Celcius1/Old-Projects-become-New/Lyrebird Keyboard/Lyrebird Keyboard Power Supply/Lyrebird Keyboard Power Supply.pdf

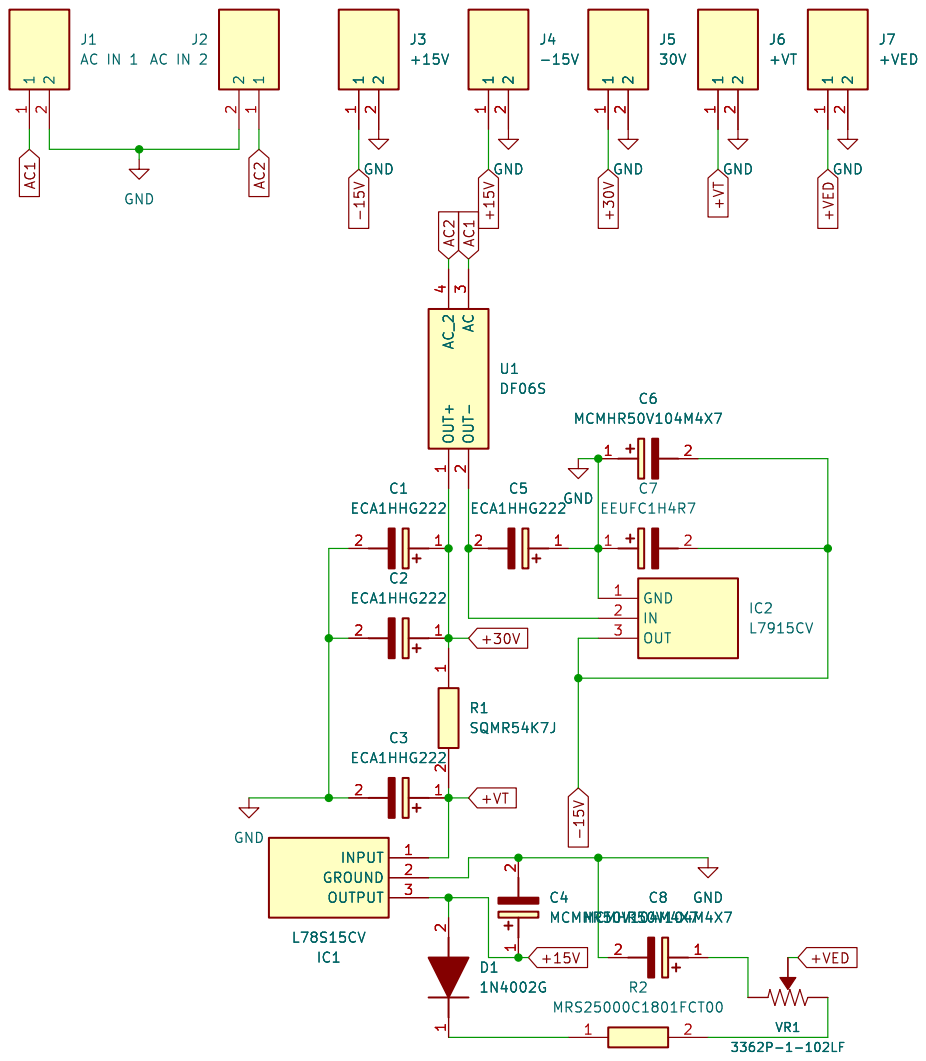
[picture p1: page 1]
