Celcius1/Old-Projects-become-New/Lyrebird Keyboard/Lyrebird Keyboard Tone Generator/Lyrebird Keyboard Tone Generator.pdf

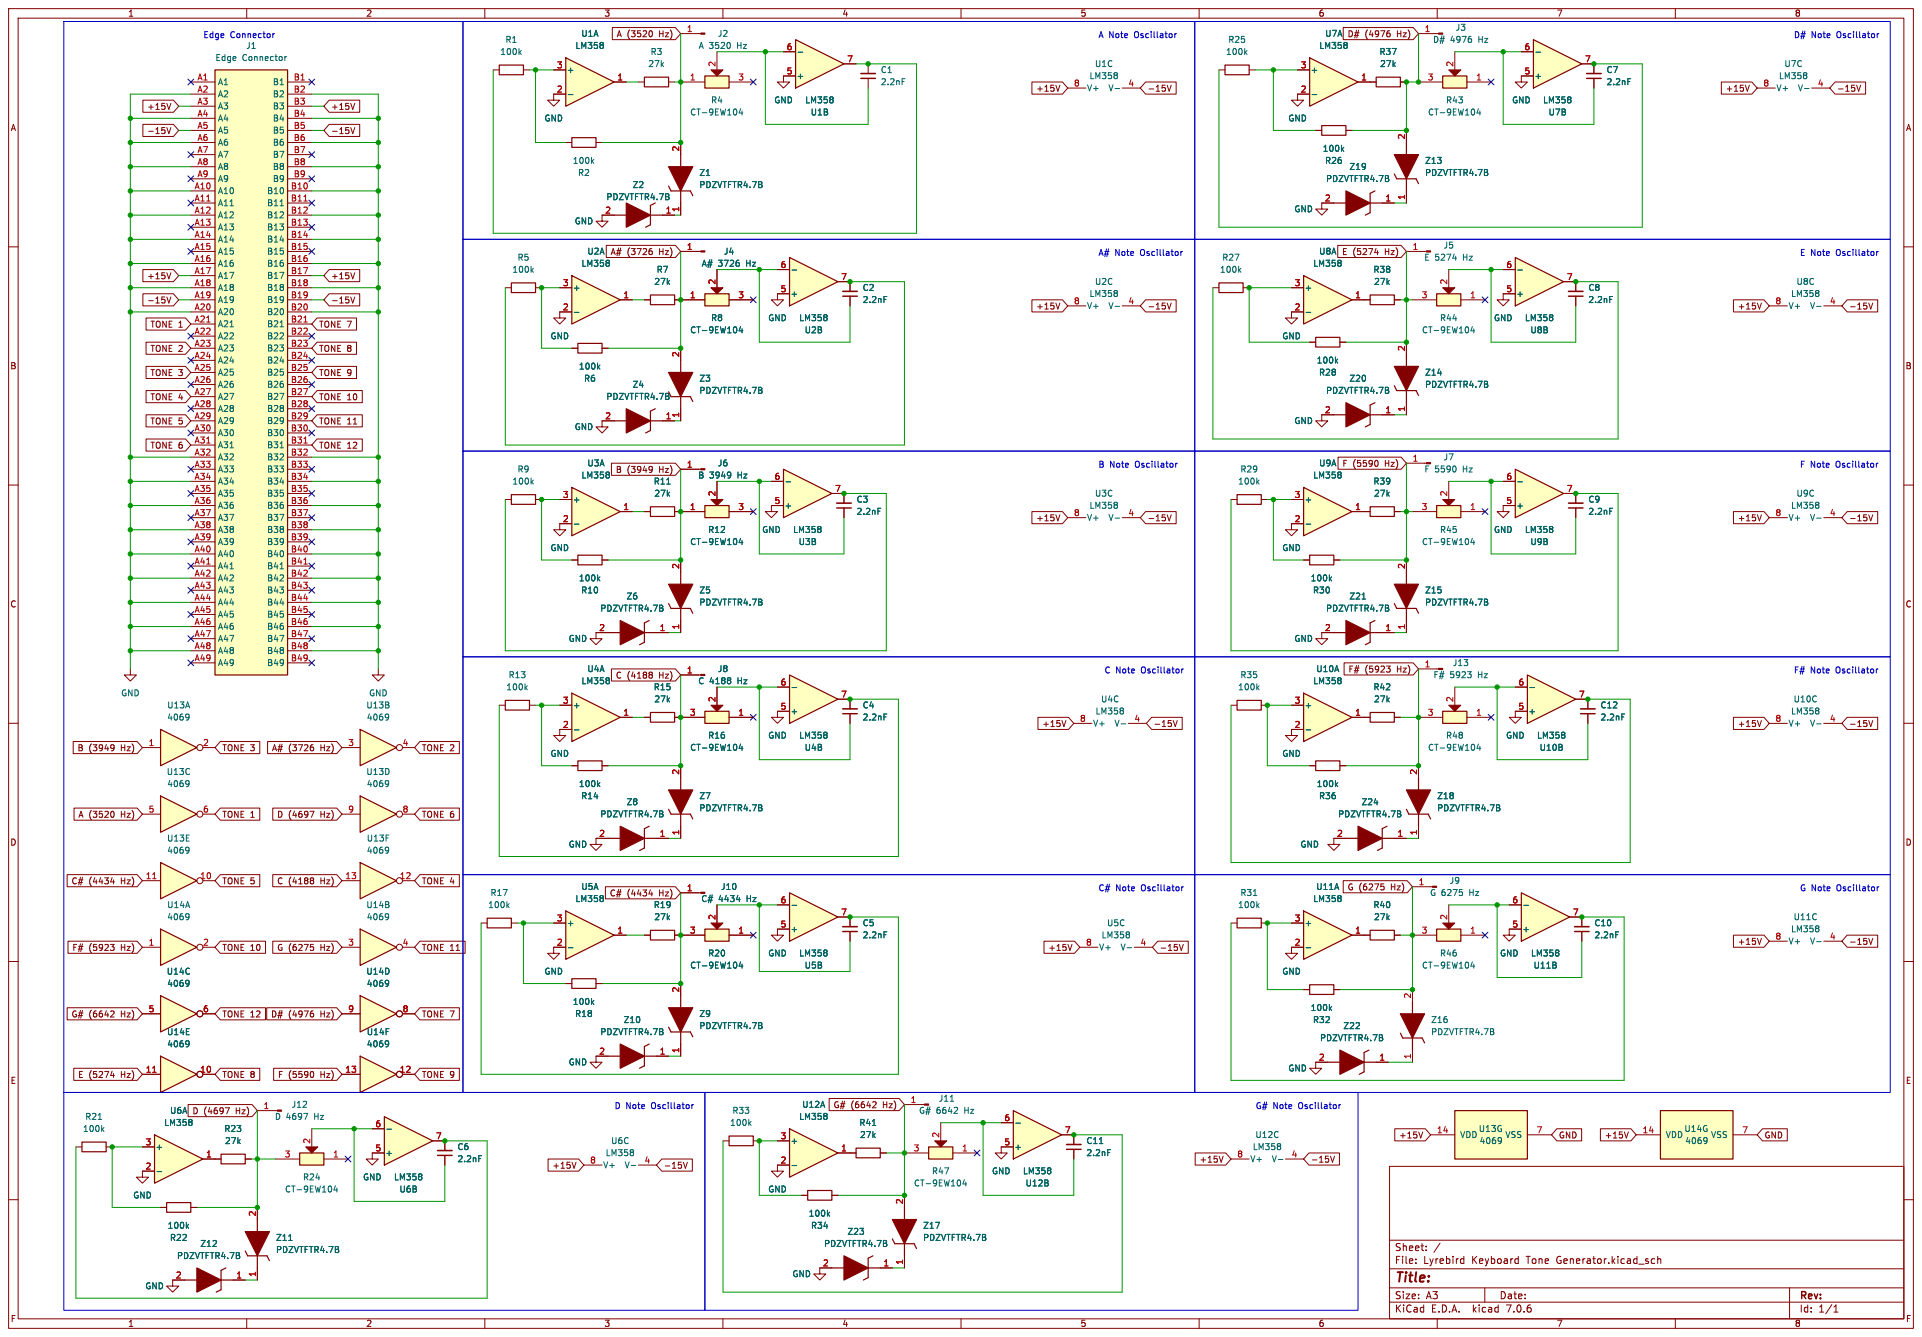
[picture p2: page 1]

E Note Oscillator F Note Oscillator

C Note Oscillator C# Note Oscillator

G Note Oscillator G# Note Oscillator
