Celcius1/Old-Projects-become-New/Lyrebird Keyboard/Lyrebird Keyboard Interconnect Mainboard/Lyrebird Keyboard Interconnect Mainboard.kicad_pcb

## KiCad design Lyrebird Keyboard/Lyrebird Keyboard Interconnect Mainboard/Lyrebird Keyboard Interconnect Mainboard.kicad_pcb (2024-01-26)

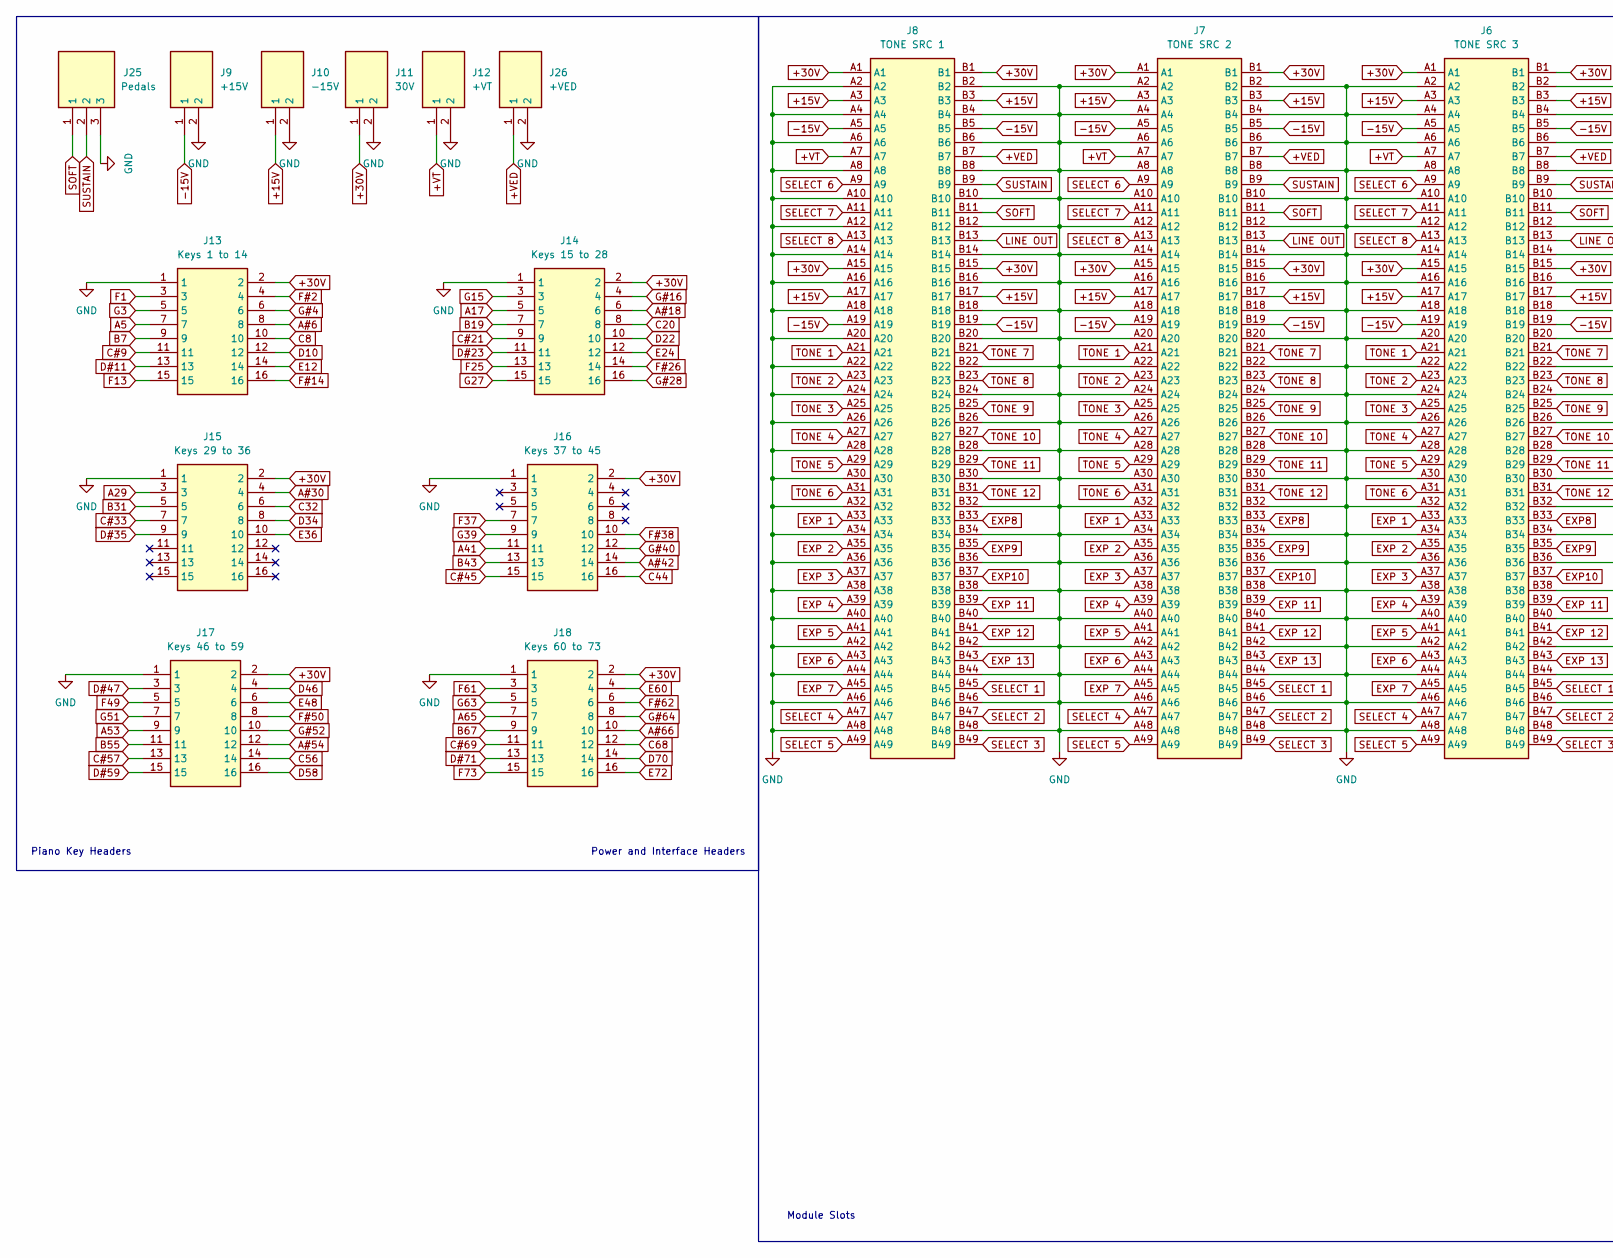
[picture p3: schematic Lyrebird Keyboard Interconnect Mainboard.kicad_sch, Lyrebird Piano Recreation, part in row 1, column 1]

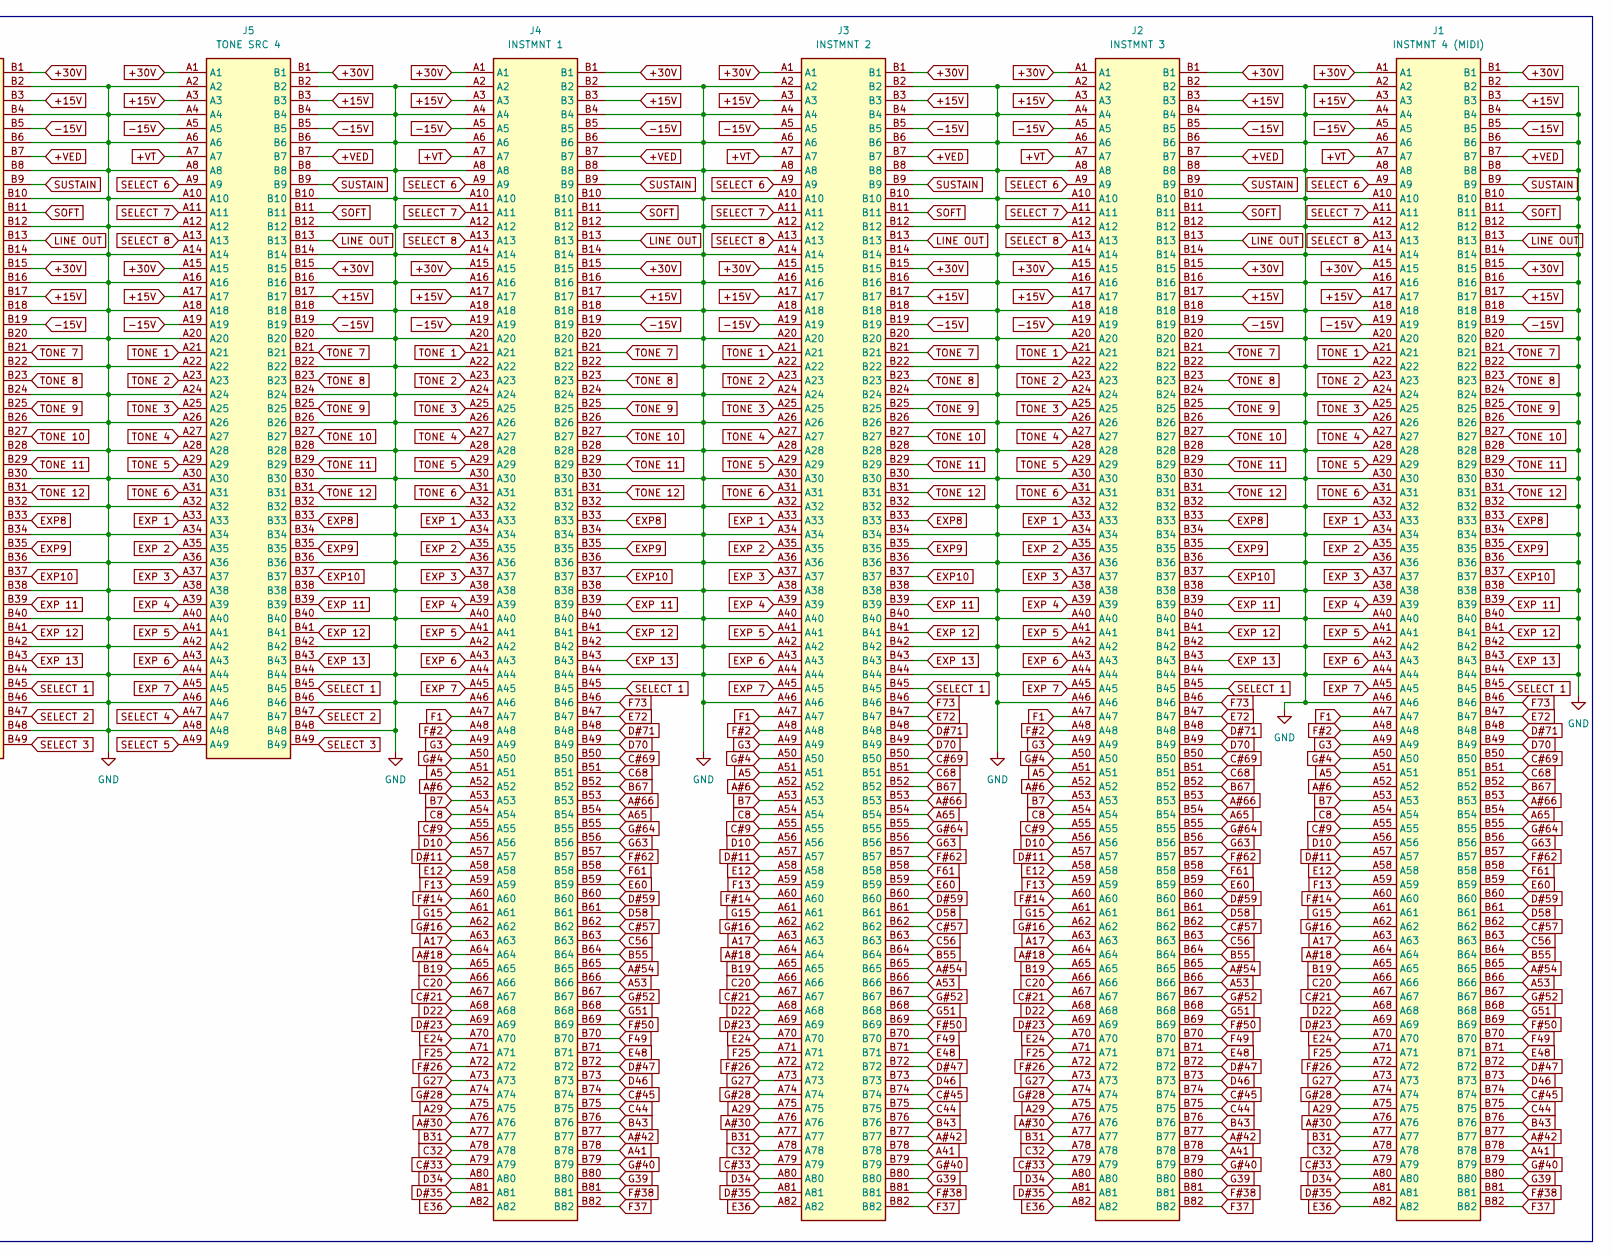
[picture p4: schematic Lyrebird Keyboard Interconnect Mainboard.kicad_sch, Lyrebird Piano Recreation, part in row 1, column 2]

Parts:
J1: INSTMNT 4 (MIDI); 877159306; Manufacturer_Part_Number 87715-9306
J2: INSTMNT 3; 877159306; Manufacturer_Part_Number 87715-9306
J3: INSTMNT 2; 877159306; Manufacturer_Part_Number 87715-9306
J4: INSTMNT 1; 877159306; Manufacturer_Part_Number 87715-9306
J5: TONE SRC 4; 1001878410212TLF; Manufacturer_Part_Number 10018784-10212TLF
J6: TONE SRC 3; 1001878410212TLF; Manufacturer_Part_Number 10018784-10212TLF
J7: TONE SRC 2; 1001878410212TLF; Manufacturer_Part_Number 10018784-10212TLF
J8: TONE SRC 1; 1001878410212TLF; Manufacturer_Part_Number 10018784-10212TLF
J9: +15V; 17761192; Manufacturer_Part_Number 1776119-2
J10: -15V; 17761192; Manufacturer_Part_Number 1776119-2
J11: 30V; 17761192; Manufacturer_Part_Number 1776119-2
J12: +VT; 17761192; Manufacturer_Part_Number 1776119-2
J13: Keys 1 to 14; SHDR16W64P254_2X8_2798X910X910P; Manufacturer_Part_Number MC-254-16-00-ST-DIP
J14: Keys 15 to 28; SHDR16W64P254_2X8_2798X910X910P; Manufacturer_Part_Number MC-254-16-00-ST-DIP
J15: Keys 29 to 36; SHDR16W64P254_2X8_2798X910X910P; Manufacturer_Part_Number MC-254-16-00-ST-DIP
J16: Keys 37 to 45; SHDR16W64P254_2X8_2798X910X910P; Manufacturer_Part_Number MC-254-16-00-ST-DIP
J17: Keys 46 to 59; SHDR16W64P254_2X8_2798X910X910P; Manufacturer_Part_Number MC-254-16-00-ST-DIP
J18: Keys 60 to 73; SHDR16W64P254_2X8_2798X910X910P; Manufacturer_Part_Number MC-254-16-00-ST-DIP
J25: Pedals; CTB05083; Manufacturer_Part_Number CTB0508/3
J26: +VED; 17761192; Manufacturer_Part_Number 1776119-2

Connections:
+15V: J1.A3, J1.A17, J1.B3, J1.B17, J2.A3, J2.A17, J2.B3, J2.B17, J3.A3, J3.A17, J3.B3, J3.B17, J4.A3, J4.A17, J4.B3, J4.B17, J5.A3, J5.A17, J5.B3, J5.B17, J6.A3, J6.A17, J6.B3, J6.B17, J7.A3, J7.A17, J7.B3, J7.B17, J8.A3, J8.A17, J8.B3, J8.B17, J10.1
+30V: J1.A1, J1.A15, J1.B1, J1.B15, J2.A1, J2.A15, J2.B1, J2.B15, J3.A1, J3.A15, J3.B1, J3.B15, J4.A1, J4.A15, J4.B1, J4.B15, J5.A1, J5.A15, J5.B1, J5.B15, J6.A1, J6.A15, J6.B1, J6.B15, J7.A1, J7.A15, J7.B1, J7.B15, J8.A1, J8.A15, J8.B1, J8.B15, J11.1, J13.2, J14.2, J15.2, J16.2, J17.2, J18.2
+VED: J1.B7, J2.B7, J3.B7, J4.B7, J5.B7, J6.B7, J7.B7, J8.B7, J26.1
+VT: J1.A7, J2.A7, J3.A7, J4.A7, J5.A7, J6.A7, J7.A7, J8.A7, J12.1
-15V: J1.A5, J1.A19, J1.B5, J1.B19, J2.A5, J2.A19, J2.B5, J2.B19, J3.A5, J3.A19, J3.B5, J3.B19, J4.A5, J4.A19, J4.B5, J4.B19, J5.A5, J5.A19, J5.B5, J5.B19, J6.A5, J6.A19, J6.B5, J6.B19, J7.A5, J7.A19, J7.B5, J7.B19, J8.A5, J8.A19, J8.B5, J8.B19, J9.1
A5: J1.A51, J2.A51, J3.A51, J4.A51, J13.7
A17: J1.A63, J2.A63, J3.A63, J4.A63, J14.5
A29: J1.A75, J2.A75, J3.A75, J4.A75, J15.3
A41: J1.B78, J2.B78, J3.B78, J4.B78, J16.11
A53: J1.B66, J2.B66, J3.B66, J4.B66, J17.9
A65: J1.B54, J2.B54, J3.B54, J4.B54, J18.7
A#6: J1.A52, J2.A52, J3.A52, J4.A52, J13.8
A#18: J1.A64, J2.A64, J3.A64, J4.A64, J14.6
A#30: J1.A76, J2.A76, J3.A76, J4.A76, J15.4
A#42: J1.B77, J2.B77, J3.B77, J4.B77, J16.14
A#54: J1.B65, J2.B65, J3.B65, J4.B65, J17.12
A#66: J1.B53, J2.B53, J3.B53, J4.B53, J18.10
B7: J1.A53, J2.A53, J3.A53, J4.A53, J13.9
B19: J1.A65, J2.A65, J3.A65, J4.A65, J14.7
B31: J1.A77, J2.A77, J3.A77, J4.A77, J15.5
B43: J1.B76, J2.B76, J3.B76, J4.B76, J16.13
B55: J1.B64, J2.B64, J3.B64, J4.B64, J17.11
B67: J1.B52, J2.B52, J3.B52, J4.B52, J18.9
C8: J1.A54, J2.A54, J3.A54, J4.A54, J13.10
C20: J1.A66, J2.A66, J3.A66, J4.A66, J14.8
C32: J1.A78, J2.A78, J3.A78, J4.A78, J15.6
C44: J1.B75, J2.B75, J3.B75, J4.B75, J16.16
C56: J1.B63, J2.B63, J3.B63, J4.B63, J17.14
C68: J1.B51, J2.B51, J3.B51, J4.B51, J18.12
C#9: J1.A55, J2.A55, J3.A55, J4.A55, J13.11
C#21: J1.A67, J2.A67, J3.A67, J4.A67, J14.9
C#33: J1.A79, J2.A79, J3.A79, J4.A79, J15.7
C#45: J1.B74, J2.B74, J3.B74, J4.B74, J16.15
C#57: J1.B62, J2.B62, J3.B62, J4.B62, J17.13
C#69: J1.B50, J2.B50, J3.B50, J4.B50, J18.11
D10: J1.A56, J2.A56, J3.A56, J4.A56, J13.12
D22: J1.A68, J2.A68, J3.A68, J4.A68, J14.10
D34: J1.A80, J2.A80, J3.A80, J4.A80, J15.8
D46: J1.B73, J2.B73, J3.B73, J4.B73, J17.4
D58: J1.B61, J2.B61, J3.B61, J4.B61, J17.16
D70: J1.B49, J2.B49, J3.B49, J4.B49, J18.14
D#11: J1.A57, J2.A57, J3.A57, J4.A57, J13.13
D#23: J1.A69, J2.A69, J3.A69, J4.A69, J14.11
D#35: J1.A81, J2.A81, J3.A81, J4.A81, J15.9
D#47: J1.B72, J2.B72, J3.B72, J4.B72, J17.3
D#59: J1.B60, J2.B60, J3.B60, J4.B60, J17.15
D#71: J1.B48, J2.B48, J3.B48, J4.B48, J18.13
E12: J1.A58, J2.A58, J3.A58, J4.A58, J13.14
E24: J1.A70, J2.A70, J3.A70, J4.A70, J14.12
E36: J1.A82, J2.A82, J3.A82, J4.A82, J15.10
E48: J1.B71, J2.B71, J3.B71, J4.B71, J17.6
E60: J1.B59, J2.B59, J3.B59, J4.B59, J18.4
E72: J1.B47, J2.B47, J3.B47, J4.B47, J18.16
EXP8: J1.B33, J2.B33, J3.B33, J4.B33, J5.B33, J6.B33, J7.B33, J8.B33
EXP9: J1.B35, J2.B35, J3.B35, J4.B35, J5.B35, J6.B35, J7.B35, J8.B35
EXP10: J1.B37, J2.B37, J3.B37, J4.B37, J5.B37, J6.B37, J7.B37, J8.B37
EXP 1: J1.A33, J2.A33, J3.A33, J4.A33, J5.A33, J6.A33, J7.A33, J8.A33
EXP 2: J1.A35, J2.A35, J3.A35, J4.A35, J5.A35, J6.A35, J7.A35, J8.A35
EXP 3: J1.A37, J2.A37, J3.A37, J4.A37, J5.A37, J6.A37, J7.A37, J8.A37
EXP 4: J1.A39, J2.A39, J3.A39, J4.A39, J5.A39, J6.A39, J7.A39, J8.A39
EXP 5: J1.A41, J2.A41, J3.A41, J4.A41, J5.A41, J6.A41, J7.A41, J8.A41
EXP 6: J1.A43, J2.A43, J3.A43, J4.A43, J5.A43, J6.A43, J7.A43, J8.A43
EXP 7: J1.A45, J2.A45, J3.A45, J4.A45, J5.A45, J6.A45, J7.A45, J8.A45
EXP 11: J1.B39, J2.B39, J3.B39, J4.B39, J5.B39, J6.B39, J7.B39, J8.B39
EXP 12: J1.B41, J2.B41, J3.B41, J4.B41, J5.B41, J6.B41, J7.B41, J8.B41
EXP 13: J1.B43, J2.B43, J3.B43, J4.B43, J5.B43, J6.B43, J7.B43, J8.B43
F1: J1.A47, J2.A47, J3.A47, J4.A47, J13.3
F13: J1.A59, J2.A59, J3.A59, J4.A59, J13.15
F25: J1.A71, J2.A71, J3.A71, J4.A71, J14.13
F37: J1.B82, J2.B82, J3.B82, J4.B82, J16.7
F49: J1.B70, J2.B70, J3.B70, J4.B70, J17.5
F61: J1.B58, J2.B58, J3.B58, J4.B58, J18.3
F73: J1.B46, J2.B46, J3.B46, J4.B46, J18.15
F#2: J1.A48, J2.A48, J3.A48, J4.A48, J13.4
F#14: J1.A60, J2.A60, J3.A60, J4.A60, J13.16
F#26: J1.A72, J2.A72, J3.A72, J4.A72, J14.14
F#38: J1.B81, J2.B81, J3.B81, J4.B81, J16.10
F#50: J1.B69, J2.B69, J3.B69, J4.B69, J17.8
F#62: J1.B57, J2.B57, J3.B57, J4.B57, J18.6
G3: J1.A49, J2.A49, J3.A49, J4.A49, J13.5
G15: J1.A61, J2.A61, J3.A61, J4.A61, J14.3
G27: J1.A73, J2.A73, J3.A73, J4.A73, J14.15
G39: J1.B80, J2.B80, J3.B80, J4.B80, J16.9
G51: J1.B68, J2.B68, J3.B68, J4.B68, J17.7
G63: J1.B56, J2.B56, J3.B56, J4.B56, J18.5
G#4: J1.A50, J2.A50, J3.A50, J4.A50, J13.6
G#16: J1.A62, J2.A62, J3.A62, J4.A62, J14.4
G#28: J1.A74, J2.A74, J3.A74, J4.A74, J14.16
G#40: J1.B79, J2.B79, J3.B79, J4.B79, J16.12
G#52: J1.B67, J2.B67, J3.B67, J4.B67, J17.10
G#64: J1.B55, J2.B55, J3.B55, J4.B55, J18.8
GND: J1.A2, J1.A4, J1.A6, J1.A8, J1.A10, J1.A12, J1.A14, J1.A16, J1.A18, J1.A20, J1.A22, J1.A24, J1.A26, J1.A28, J1.A30, J1.A32, J1.A34, J1.A36, J1.A38, J1.A40, J1.A42, J1.A44, J1.A46, J1.B2, J1.B4, J1.B6, J1.B8, J1.B10, J1.B12, J1.B14, J1.B16, J1.B18, J1.B20, J1.B22, J1.B24, J1.B26, J1.B28, J1.B30, J1.B32, J1.B34, J1.B36, J1.B38, J1.B40, J1.B42, J1.B44, J2.A2, J2.A4, J2.A6, J2.A8, J2.A10, J2.A12, J2.A14, J2.A16, J2.A18, J2.A20, J2.A22, J2.A24, J2.A26, J2.A28, J2.A30, J2.A32, J2.A34, J2.A36, J2.A38, J2.A40, J2.A42, J2.A44, J2.A46, J2.B2, J2.B4, J2.B6, J2.B8, J2.B10, J2.B12, J2.B14, J2.B16, J2.B18, J2.B20, J2.B22, J2.B24, J2.B26, J2.B28, J2.B30, J2.B32, J2.B34, J2.B36, J2.B38, J2.B40, J2.B42, J2.B44, J3.A2, J3.A4, J3.A6, J3.A8, J3.A10, J3.A12, J3.A14, J3.A16, J3.A18, J3.A20, J3.A22, J3.A24, J3.A26, J3.A28, J3.A30, J3.A32, J3.A34, J3.A36, J3.A38, J3.A40, J3.A42, J3.A44, J3.A46, J3.B2, J3.B4, J3.B6, J3.B8, J3.B10, J3.B12, J3.B14, J3.B16, J3.B18, J3.B20, J3.B22, J3.B24, J3.B26, J3.B28, J3.B30, J3.B32, J3.B34, J3.B36, J3.B38, J3.B40, J3.B42, J3.B44, J4.A2, J4.A4, J4.A6, J4.A8, J4.A10, J4.A12, J4.A14, J4.A16, J4.A18, J4.A20, J4.A22, J4.A24, J4.A26, J4.A28, J4.A30, J4.A32, J4.A34, J4.A36, J4.A38, J4.A40, J4.A42, J4.A44, J4.A46, J4.B2, J4.B4, J4.B6, J4.B8, J4.B10, J4.B12, J4.B14, J4.B16, J4.B18, J4.B20, J4.B22, J4.B24, J4.B26, J4.B28, J4.B30, J4.B32, J4.B34, J4.B36, J4.B38, J4.B40, J4.B42, J4.B44, J5.A2, J5.A4, J5.A6, J5.A8, J5.A10, J5.A12, J5.A14, J5.A16, J5.A18, J5.A20, J5.A22, J5.A24, J5.A26, J5.A28, J5.A30, J5.A32, J5.A34, J5.A36, J5.A38, J5.A40, J5.A42, J5.A44, J5.A46, J5.A48, J5.B2, J5.B4, J5.B6, J5.B8, J5.B10, J5.B12, J5.B14, J5.B16, J5.B18, J5.B20, J5.B22, J5.B24, J5.B26, J5.B28, J5.B30, J5.B32, J5.B34, J5.B36, J5.B38, J5.B40, J5.B42, J5.B44, J5.B46, J5.B48, J6.A2, J6.A4, J6.A6, J6.A8, J6.A10, J6.A12, J6.A14, J6.A16, J6.A18, J6.A20, J6.A22, J6.A24, J6.A26, J6.A28, J6.A30, J6.A32, J6.A34, J6.A36, J6.A38, J6.A40, J6.A42, J6.A44, J6.A46, J6.A48, J6.B2, J6.B4, J6.B6, J6.B8, J6.B10, J6.B12, J6.B14, J6.B16, J6.B18, J6.B20, J6.B22, J6.B24, J6.B26, J6.B28, J6.B30, J6.B32, J6.B34, J6.B36, J6.B38, J6.B40, J6.B42, J6.B44, J6.B46, J6.B48, J7.A2, J7.A4, J7.A6, J7.A8, J7.A10, J7.A12, J7.A14, J7.A16, J7.A18, J7.A20, J7.A22, J7.A24, J7.A26, J7.A28, J7.A30, J7.A32, J7.A34, J7.A36, J7.A38, J7.A40, J7.A42, J7.A44, J7.A46, J7.A48, J7.B2, J7.B4, J7.B6, J7.B8, J7.B10, J7.B12, J7.B14, J7.B16, J7.B18, J7.B20, J7.B22, J7.B24, J7.B26, J7.B28, J7.B30, J7.B32, J7.B34, J7.B36, J7.B38, J7.B40, J7.B42, J7.B44, J7.B46, J7.B48, J8.A2, J8.A4, J8.A6, J8.A8, J8.A10, J8.A12, J8.A14, J8.A16, J8.A18, J8.A20, J8.A22, J8.A24, J8.A26, J8.A28, J8.A30, J8.A32, J8.A34, J8.A36, J8.A38, J8.A40, J8.A42, J8.A44, J8.A46, J8.A48, J8.B2, J8.B4, J8.B6, J8.B8, J8.B10, J8.B12, J8.B14, J8.B16, J8.B18, J8.B20, J8.B22, J8.B24, J8.B26, J8.B28, J8.B30, J8.B32, J8.B34, J8.B36, J8.B38, J8.B40, J8.B42, J8.B44, J8.B46, J8.B48, J9.2, J10.2, J11.2, J12.2, J13.1, J14.1, J15.1, J16.1, J17.1, J18.1, J25.3, J26.2
LINE OUT: J1.B13, J2.B13, J3.B13, J4.B13, J5.B13, J6.B13, J7.B13, J8.B13
SELECT 1: J1.B45, J2.B45, J3.B45, J4.B45, J5.B45, J6.B45, J7.B45, J8.B45
SELECT 2: J5.B47, J6.B47, J7.B47, J8.B47
SELECT 3: J5.B49, J6.B49, J7.B49, J8.B49
SELECT 4: J5.A47, J6.A47, J7.A47, J8.A47
SELECT 5: J5.A49, J6.A49, J7.A49, J8.A49
SELECT 6: J1.A9, J2.A9, J3.A9, J4.A9, J5.A9, J6.A9, J7.A9, J8.A9
SELECT 7: J1.A11, J2.A11, J3.A11, J4.A11, J5.A11, J6.A11, J7.A11, J8.A11
SELECT 8: J1.A13, J2.A13, J3.A13, J4.A13, J5.A13, J6.A13, J7.A13, J8.A13
SOFT: J1.B11, J2.B11, J3.B11, J4.B11, J5.B11, J6.B11, J7.B11, J8.B11, J25.1
SUSTAIN: J1.B9, J2.B9, J3.B9, J4.B9, J5.B9, J6.B9, J7.B9, J8.B9, J25.2
TONE 1: J1.A21, J2.A21, J3.A21, J4.A21, J5.A21, J6.A21, J7.A21, J8.A21
TONE 2: J1.A23, J2.A23, J3.A23, J4.A23, J5.A23, J6.A23, J7.A23, J8.A23
TONE 3: J1.A25, J2.A25, J3.A25, J4.A25, J5.A25, J6.A25, J7.A25, J8.A25
TONE 4: J1.A27, J2.A27, J3.A27, J4.A27, J5.A27, J6.A27, J7.A27, J8.A27
TONE 5: J1.A29, J2.A29, J3.A29, J4.A29, J5.A29, J6.A29, J7.A29, J8.A29
TONE 6: J1.A31, J2.A31, J3.A31, J4.A31, J5.A31, J6.A31, J7.A31, J8.A31
TONE 7: J1.B21, J2.B21, J3.B21, J4.B21, J5.B21, J6.B21, J7.B21, J8.B21
TONE 8: J1.B23, J2.B23, J3.B23, J4.B23, J5.B23, J6.B23, J7.B23, J8.B23
TONE 9: J1.B25, J2.B25, J3.B25, J4.B25, J5.B25, J6.B25, J7.B25, J8.B25
TONE 10: J1.B27, J2.B27, J3.B27, J4.B27, J5.B27, J6.B27, J7.B27, J8.B27
TONE 11: J1.B29, J2.B29, J3.B29, J4.B29, J5.B29, J6.B29, J7.B29, J8.B29
TONE 12: J1.B31, J2.B31, J3.B31, J4.B31, J5.B31, J6.B31, J7.B31, J8.B31

Notes on the sheet:
Piano Key Headers
Power and Interface Headers
Module Slots

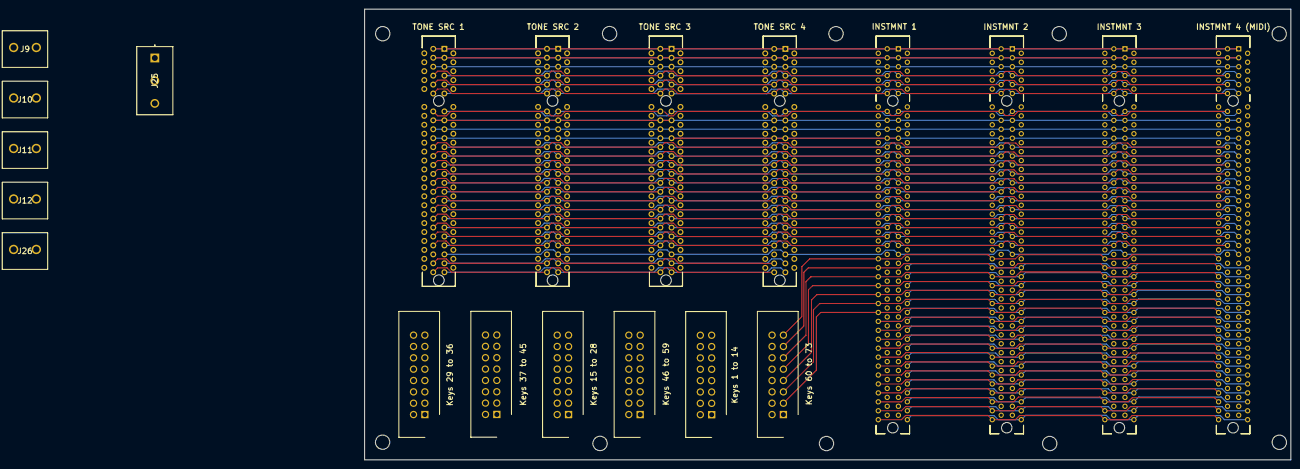
[picture p5: board Lyrebird Keyboard Interconnect Mainboard.kicad_pcb from above]

Board: 4 copper layers, 207.3 x 100.9 mm, 20 parts (0 on the bottom side), 115 nets.
