Celcius1/Old-Projects-become-New/Lyrebird Keyboard/Lyrebird Keyboard Class D Amp Card/Lyrebird Keyboard Class D Amp Card.kicad_pcb

## KiCad design Lyrebird Keyboard/Lyrebird Keyboard Class D Amp Card/Lyrebird Keyboard Class D Amp Card.kicad_pcb (2023-12-20)

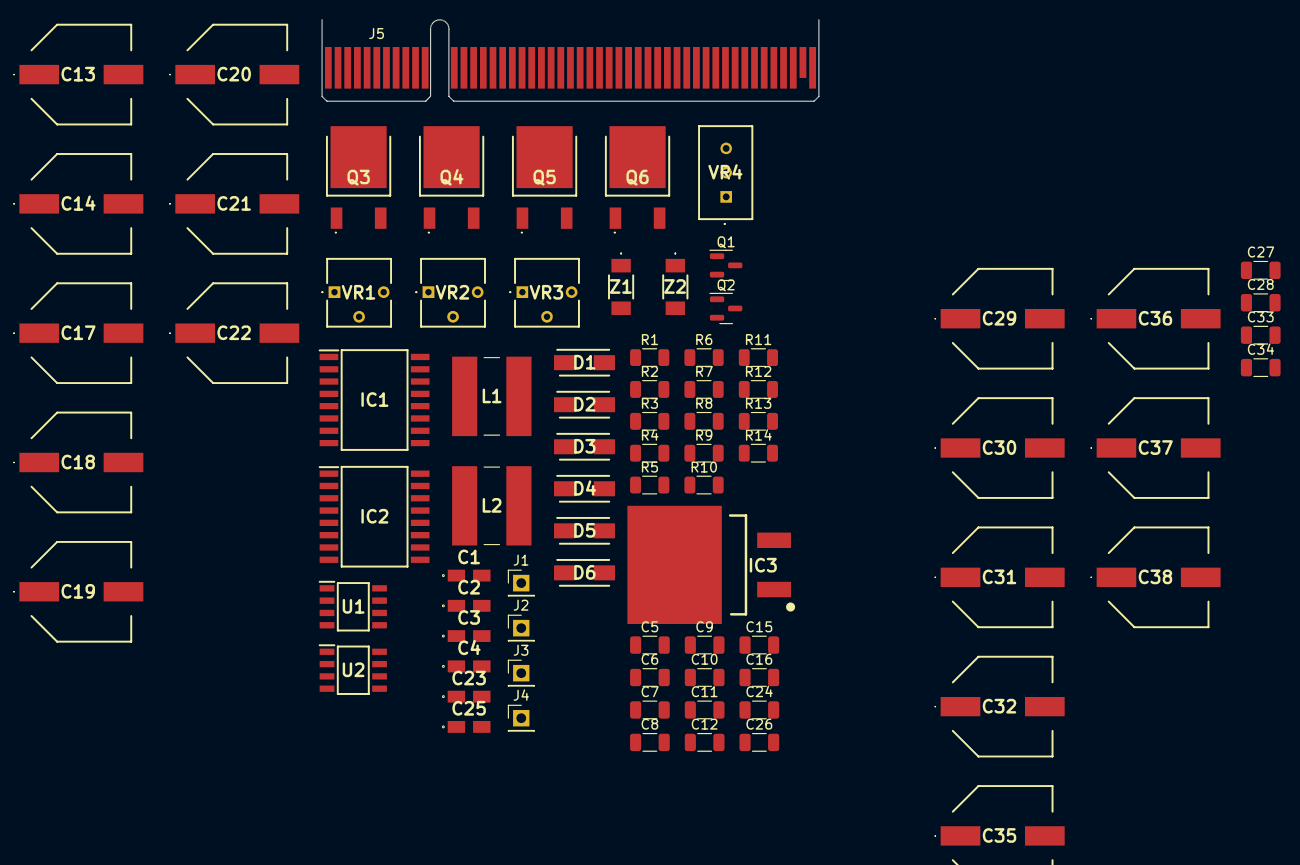
[picture p6: board Lyrebird Keyboard Class D Amp Card.kicad_pcb from above]

Board: 2 copper layers, 82 parts (0 on the bottom side), 36 nets, no tracks yet.

Parts:
C1, C2, C3, C4, C23, C25: T491A225K016AT; T491A
C5, C6, C11, C12, C28, C34: 220nF; C_1206_3216Metric
C7, C8: 22uF; C_1206_3216Metric
C9, C10, C27, C33: 100nF; C_1206_3216Metric
C13, C14, C17, C18, C19, C20, C21, C22, C29, C30, C31, C32, C35, C36, C37, C38: EEEFK1H221P; EEE0JA152UAP
C15: 390nF; C_1206_3216Metric
C16: 5.6uF; C_1206_3216Metric
C24: 68nF; C_1206_3216Metric
C26: 1nF; C_1206_3216Metric
D1, D2, D3, D4, D5, D6: US1M-E3_5AT; DIOM5127X229N
IC1, IC2: IR2113SPBF; SOIC127P1032X265-16N
IC3: L7805ACD2T-TR; D2PAK-STB35NF10T4
J1: Bias Test Point 1; PinHeader_1x01_P2.54mm_Vertical
J2: Bias Test Point 2; PinHeader_1x01_P2.54mm_Vertical
J3: Square Test; PinHeader_1x01_P2.54mm_Vertical
J4: Triangle Test; PinHeader_1x01_P2.54mm_Vertical
J5: Edge Connector; BUS_PCIexpress_x8
L1, L2: SRN8040-220M; SRN8040220M
Q1, Q2: BC848; SOT-23
Q3, Q4, Q5, Q6: IRFR2905ZTRPBF
R1, R2, R3, R4, R5, R6, R11: 10k; R_1206_3216Metric
R7, R8, R9, R10: 10R; R_1206_3216Metric
R12, R13: 100k; R_1206_3216Metric
R14: 5k1; R_1206_3216Metric
U1: SOIC127P600X175-8N
U2: LM358; SOIC127P600X175-8N
VR1, VR2, VR3: T73YP103KT20
VR4: CT-9EW104; CT9EW104
Z1, Z2: PDZVTFTR4.7B; PDZVTFTR47B

Connections:
+5V: C1.1 (+), C2.1 (+), C3.1 (+), C4.1 (+), C23.1 (+), C25.1 (+), IC1.11 (VDD), IC2.11 (VDD), IC3.3 (OUTPUT), R3.1, R4.1, R5.2, R6.2, U1.8 (Vdd), U2.8 (V+), VR2.3 (CW), VR3.3 (CW)
+15V: C9.2, C10.2, C11.2, C12.2, C13.1 (+), C14.1 (+), C17.1 (+), C18.1 (+), C19.1 (+), C20.1 (+), C21.1 (+), C22.1 (+), D1.2 (A), D2.2 (A), IC1.3 (VCC), IC2.3 (VCC), IC3.1 (INPUT), J5.A3, J5.A17, J5.B3, J5.B17, Q3.2 (D), Q5.2 (D)
-15V: C27.1, C28.1, C29.2 (-), C30.2 (-), C31.2 (-), C32.2 (-), C33.1, C34.1, C35.2 (-), C36.2 (-), C37.2 (-), C38.2 (-), J5.A5, J5.A19, J5.B5, J5.B19, Q4.3 (S), Q6.3 (S)
AMP OUT: C15.2, L1.2
GND: C1.2 (-), C2.2 (-), C3.2 (-), C4.2 (-), C9.1, C10.1, C11.1, C12.1, C13.2 (-), C14.2 (-), C15.1, C16.1, C17.2 (-), C18.2 (-), C19.2 (-), C20.2 (-), C21.2 (-), C22.2 (-), C23.2 (-), C24.1, C25.2 (-), C27.2, C28.2, C29.1 (+), C30.1 (+), C31.1 (+), C32.1 (+), C33.2, C34.2, C35.1 (+), C36.1 (+), C37.1 (+), C38.1 (+), IC1.13 (SD), IC2.13 (SD), IC3.4 (GND), J5.A2, J5.A4, J5.A6, J5.A8, J5.A10, J5.A12, J5.A14, J5.A16, J5.A18, J5.A20, J5.A32, J5.A34, J5.A36, J5.A38, J5.A40, J5.A42, J5.A44, J5.A46, J5.A48, J5.B2, J5.B4, J5.B6, J5.B8, J5.B10, J5.B12, J5.B14, J5.B16, J5.B18, J5.B20, J5.B32, J5.B34, J5.B36, J5.B38, J5.B40, J5.B42, J5.B44, J5.B46, J5.B48, Q1.2 (E), Q2.2 (E), U1.4 (Vss), U2.2 (-), U2.4 (V-), U2.5 (+), VR2.1 (CCW), VR3.1 (CCW), Z1.2 (A)
HIN1: IC1.12 (HIN), R1.1, R6.1, U1.7
HIN2: IC2.12 (HIN), R2.1, R5.1, U1.1
HO1: D5.1 (K), IC1.8 (HO), R9.2
HO2: D3.1 (K), IC2.8 (HO), R7.2
LINE INV: IC2.14 (LIN), Q2.3 (C), R4.2
LINE OUT: J5.B13, VR1.3 (CW)
LO1: D6.1 (K), IC1.1 (LO), R10.2
LO2: D4.1 (K), IC2.1 (LO), R8.2
unnamed: D3.2 (A), Q3.1 (G), R7.1
unnamed: D4.2 (A), Q4.1 (G), R8.1
unnamed: D5.2 (A), Q5.1 (G), R9.1
unnamed: D6.2 (A), Q6.1 (G), R10.1
unnamed: J1.1, U1.2 (-), VR1.1 (CCW), VR2.2 (WIPER)
unnamed: J3.1, R13.1, R14.2, VR4.1 (CCW), Z2.2 (A)
unnamed: Q1.1 (B), R1.2
unnamed: Q2.1 (B), R2.2
unnamed: R14.1, U2.1
unnamed: C24.2, R11.1, U1.6 (-)
unnamed: R12.2, R13.2, U2.3 (+)
unnamed: C26.1, U2.6 (-), VR4.2 (WIPER)
unnamed: Z1.1 (K), Z2.1 (K)
SUB IN: J2.1, R11.2, VR1.2 (WIPER), VR3.2 (WIPER)
SUB INV: IC1.14 (LIN), Q1.3 (C), R3.2
SUBWOOFER: C16.2, L2.2
TRI WAVE OUT: C26.2, J4.1, R12.1, U1.3 (+), U1.5 (+), U2.7
VB1: C6.1, C8.2, D2.1 (K), IC1.7 (VB)
VB2: C5.1, C7.2, D1.1 (K), IC2.7 (VB)
VS1: C6.2, C8.1, IC1.6 (VS), L2.1, Q5.3 (S), Q6.2 (D)
VS2: C5.2, C7.1, IC2.6 (VS), L1.1, Q3.3 (S), Q4.2 (D)
VSS1: IC1.2 (COM), IC1.15 (VSS)
VSS2: IC2.2 (COM), IC2.15 (VSS)
