Celcius1/Old-Projects-become-New/Lyrebird Keyboard/Lyrebird Keyboard Power Supply/Lyrebird Keyboard Power Supply.kicad_pcb

## KiCad design Lyrebird Keyboard/Lyrebird Keyboard Power Supply/Lyrebird Keyboard Power Supply.kicad_pcb (2023-12-20)

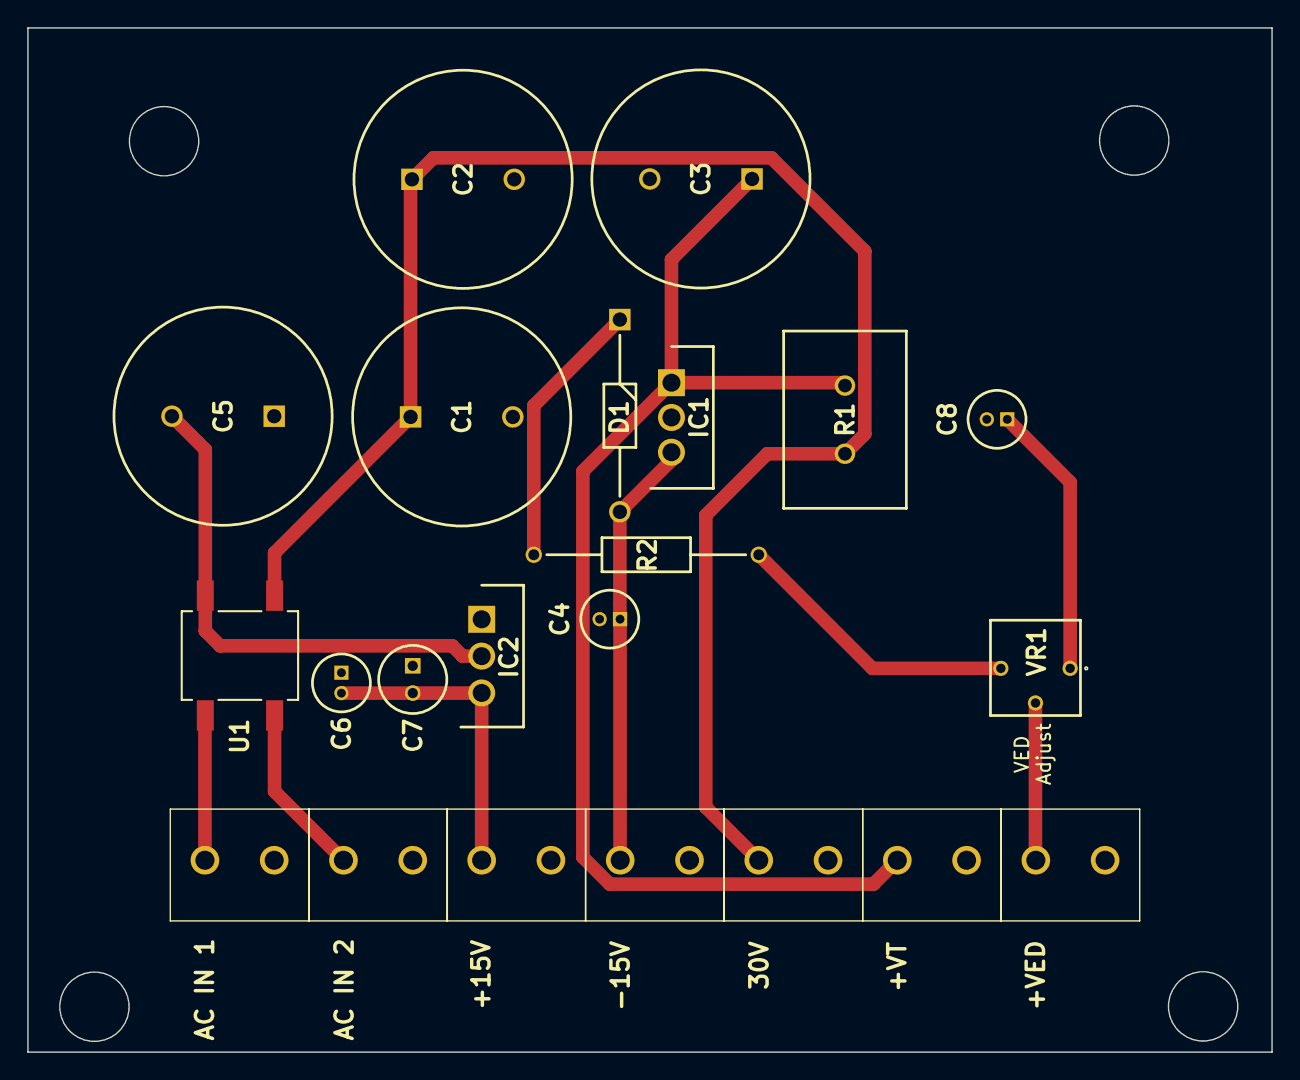
[picture p7: board Lyrebird Keyboard Power Supply.kicad_pcb from above]

Board: 2 copper layers, 91.2 x 75.1 mm, 22 parts (0 on the bottom side), 12 nets.

Parts:
C1, C2, C3, C5: ECA1HHG222; CAPPRD750W85D1600H3350
C4, C6, C8: MCMHR50V104M4X7; CAPPRD150W47D425H800
C7: EEUFC1H4R7; CAPPRD200W55D500H1250
D1: 1N4002G; DIOAD1405W86L465D235
IC1: L78S15CV; TO255P460X1020X2008-3P
IC2: L7915CV; TO270P460X1020X2008-3P
J1: AC IN 1; 17761192
J2: AC IN 2; 17761192
J3: +15V; 17761192
J4: -15V; 17761192
J5: 30V; 17761192
J6: +VT; 17761192
J7: +VED; 17761192
R1: SQMR54K7J
R2: MRS25000C1801FCT00; RESAD1650W60L650D250
U1: DF06S; SOT508P985X260-4N
VR1: 3362P-1-102LF; 3362P_1

Connections:
+15V: C4.1 (+), D1.2 (A), IC1.3 (OUTPUT), J4.1
+30V: C1.1 (+), C2.1 (+), J5.1, R1.1, U1.1 (OUT+)
+VED: J7.1, VR1.2 (WIPER)
+VT: C3.1 (+), IC1.1 (INPUT), J6.1, R1.2
-15V: C6.2 (-), C7.2 (-), IC2.3 (OUT), J3.1
AC1: J1.1, U1.3 (AC)
AC2: J2.1, U1.4 (AC_2)
GND: C1.2 (-), C2.2 (-), C3.2 (-), C4.2 (-), C5.1 (+), C6.1 (+), C7.1 (+), C8.2 (-), IC1.2 (GROUND), IC2.1 (GND), J1.2, J2.2, J3.2, J4.2, J5.2, J6.2, J7.2
unnamed: C5.2 (-), IC2.2 (IN), U1.2 (OUT-)
unnamed: C8.1 (+), VR1.1 (CCW)
unnamed: D1.1 (K), R2.1
unnamed: R2.2, VR1.3 (CW)
