Celcius1/Old-Projects-become-New/Lyrebird Keyboard/Lyrebird Keyboard Tone Generator/Lyrebird Keyboard Tone Generator.kicad_pcb

## KiCad design Lyrebird Keyboard/Lyrebird Keyboard Tone Generator/Lyrebird Keyboard Tone Generator.kicad_pcb (2023-12-18)

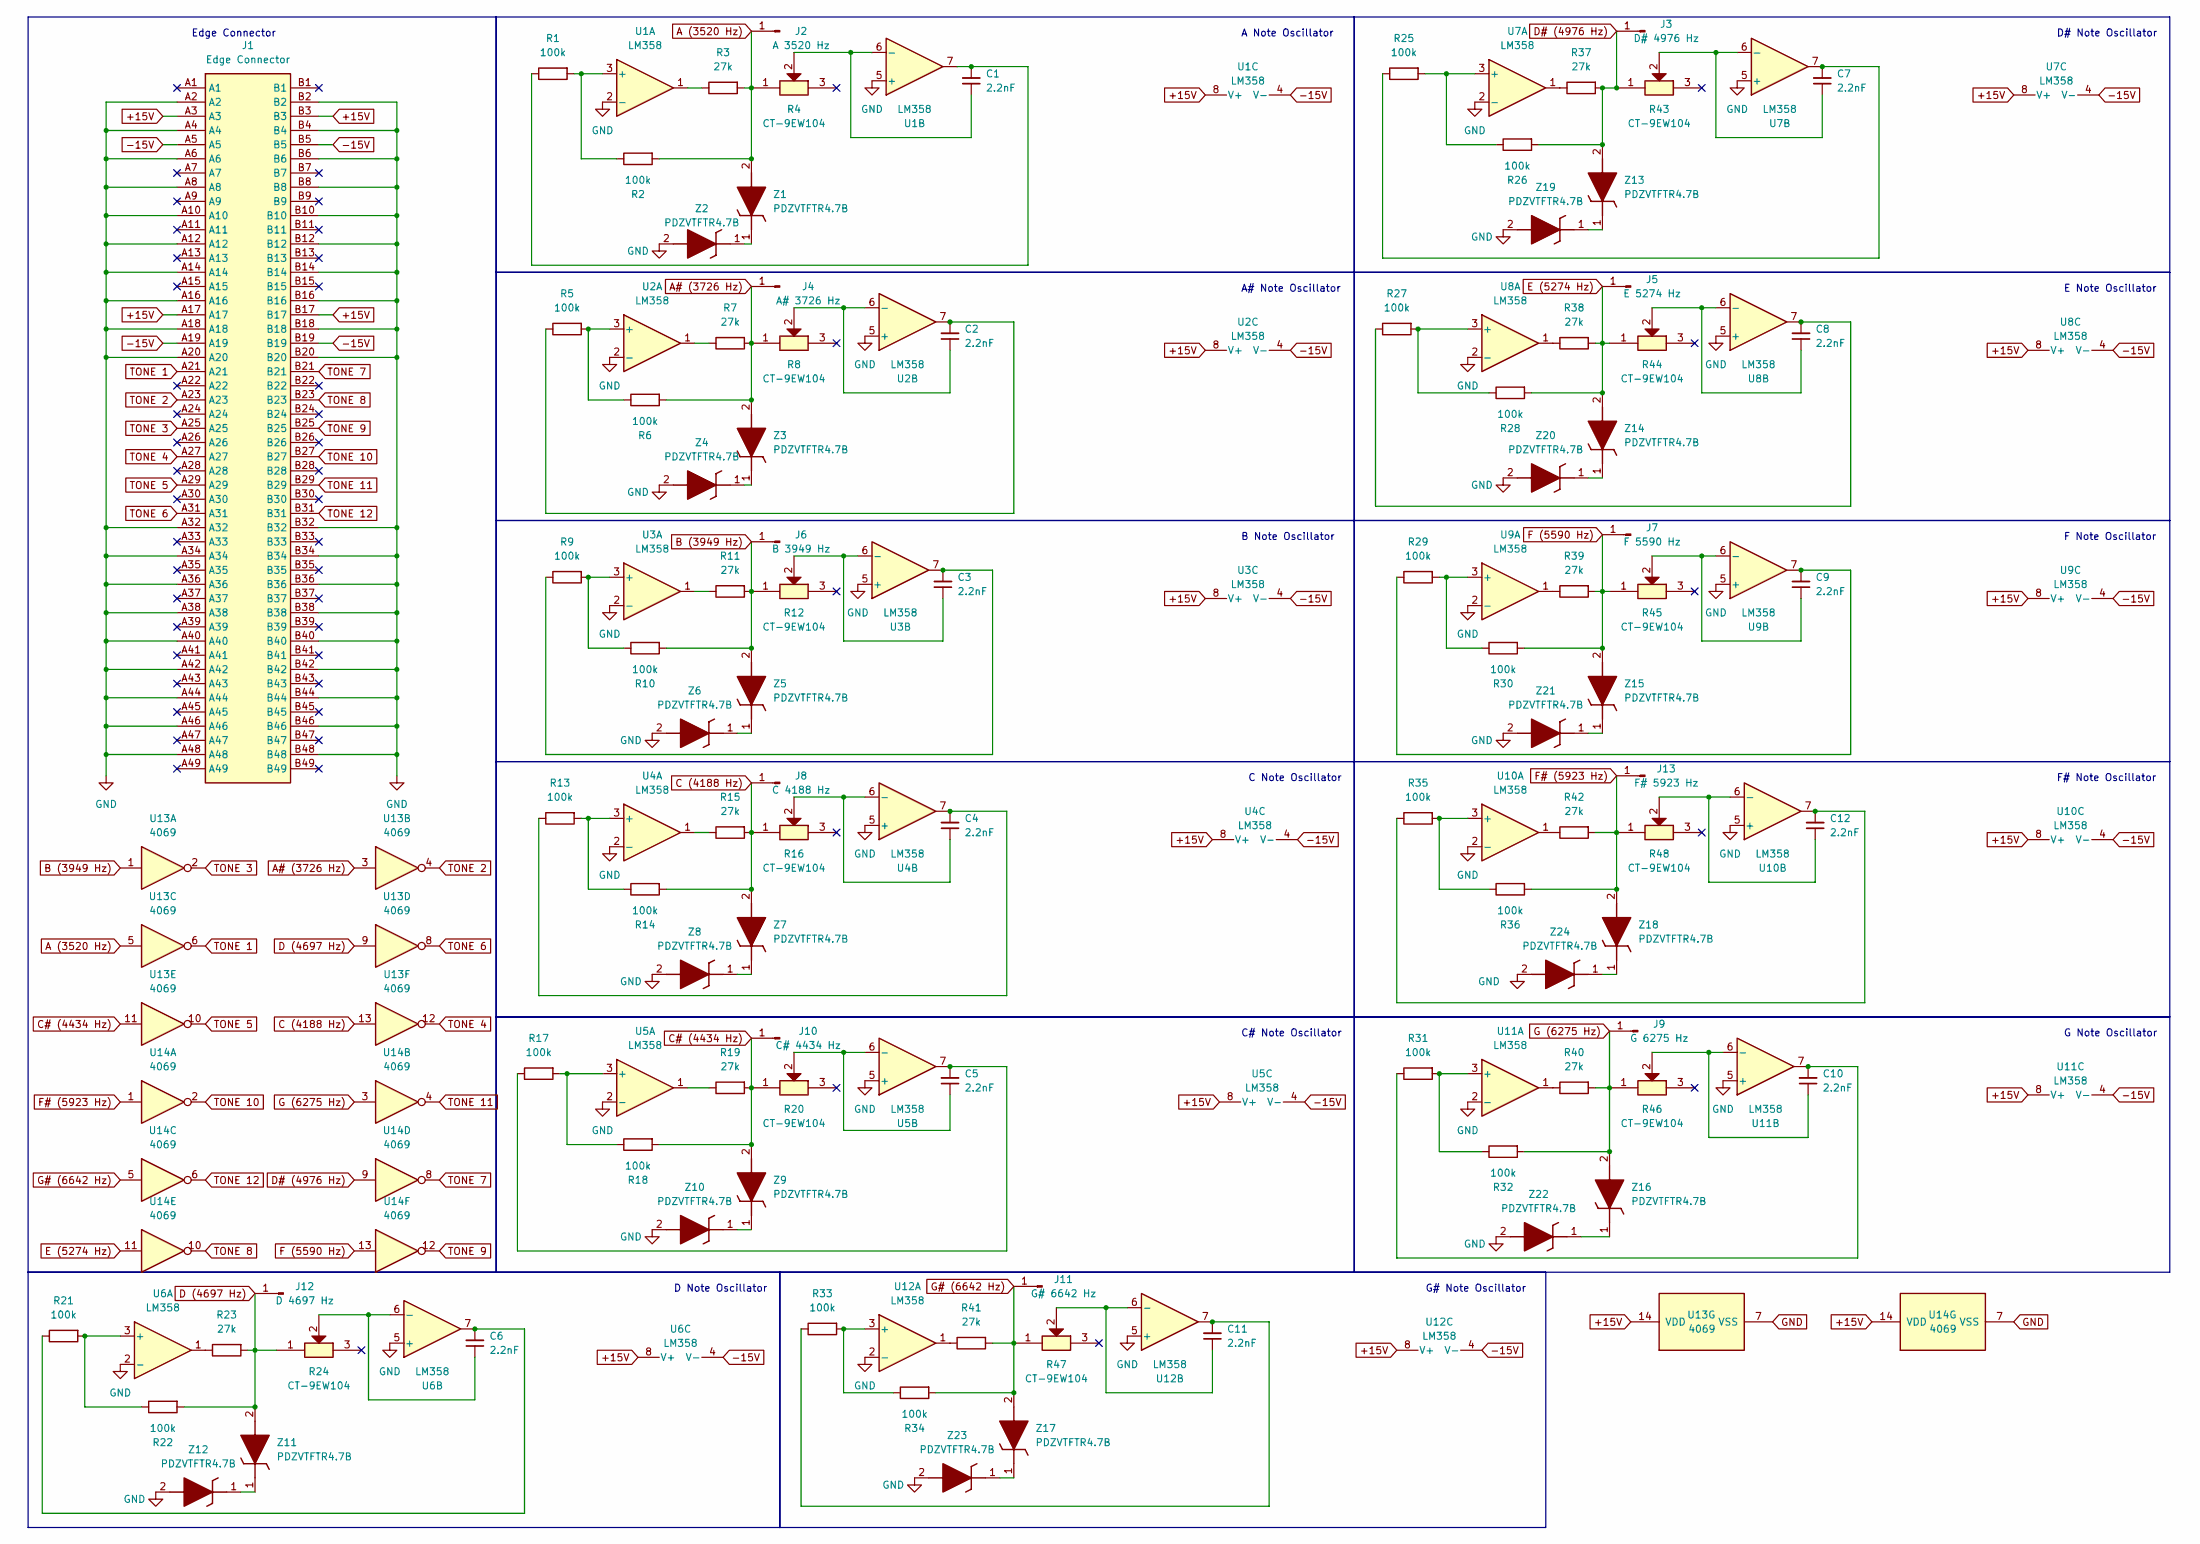
[picture p8: schematic Lyrebird Keyboard Tone Generator.kicad_sch]

Parts:
C1, C2, C3, C4, C5, C6, C7, C8, C9, C10, C11, C12: 2.2nF; C_1206_3216Metric
J1: Edge Connector; BUS_PCIexpress_x8; Manufacturer_Part_Number PCIE-098-02-F-D-TH
J2: A 3520 Hz; PinHeader_1x01_P2.54mm_Vertical
J3: D# 4976 Hz; PinHeader_1x01_P2.54mm_Vertical
J4: A# 3726 Hz; PinHeader_1x01_P2.54mm_Vertical
J5: E 5274 Hz; PinHeader_1x01_P2.54mm_Vertical
J6: B 3949 Hz; PinHeader_1x01_P2.54mm_Vertical
J7: F 5590 Hz; PinHeader_1x01_P2.54mm_Vertical
J8: C 4188 Hz; PinHeader_1x01_P2.54mm_Vertical
J9: G 6275 Hz; PinHeader_1x01_P2.54mm_Vertical
J10: C# 4434 Hz; PinHeader_1x01_P2.54mm_Vertical
J11: G# 6642 Hz; PinHeader_1x01_P2.54mm_Vertical
J12: D 4697 Hz; PinHeader_1x01_P2.54mm_Vertical
J13: F# 5923 Hz; PinHeader_1x01_P2.54mm_Vertical
R1, R2, R5, R6, R9, R10, R13, R14, R17, R18, R21, R22, R25, R26, R27, R28, R29, R30, R31, R32, R33, R34, R35, R36: 100k; R_1206_3216Metric
R3, R7, R11, R15, R19, R23, R37, R38, R39, R40, R41, R42: 27k; R_1206_3216Metric
R4, R8, R12, R16, R20, R24, R43, R44, R45, R46, R47, R48: CT-9EW104; CT9EW104; Manufacturer_Part_Number CT-9EW104
U1, U2, U3, U4, U5, U6, U7, U8, U9, U10, U11, U12: LM358; SOIC127P600X175-8N
U13, U14: 4069; SOIC127P600X175-14N
Z1, Z2, Z3, Z4, Z5, Z6, Z7, Z8, Z9, Z10, Z11, Z12, Z13, Z14, Z15, Z16, Z17, Z18, Z19, Z20, Z21, Z22, Z23, Z24: PDZVTFTR4.7B; PDZVTFTR47B; Manufacturer_Part_Number PDZVTFTR4.7B

Connections:
+15V: J1.A3, J1.A17, J1.B3, J1.B17, U1.8 (V+), U2.8 (V+), U3.8 (V+), U4.8 (V+), U5.8 (V+), U6.8 (V+), U7.8 (V+), U8.8 (V+), U9.8 (V+), U10.8 (V+), U11.8 (V+), U12.8 (V+), U13.14 (VDD), U14.14 (VDD)
-15V: J1.A5, J1.A19, J1.B5, J1.B19, U1.4 (V-), U2.4 (V-), U3.4 (V-), U4.4 (V-), U5.4 (V-), U6.4 (V-), U7.4 (V-), U8.4 (V-), U9.4 (V-), U10.4 (V-), U11.4 (V-), U12.4 (V-)
A (3520 Hz): J2.1, R2.2, R3.2, R4.1, U13.5, Z1.2 (A)
A# (3726 Hz): J4.1, R6.2, R7.2, R8.1, U13.3, Z3.2 (A)
B (3949 Hz): J6.1, R10.2, R11.2, R12.1, U13.1, Z5.2 (A)
C (4188 Hz): J8.1, R14.2, R15.2, R16.1, U13.13, Z7.2 (A)
C# (4434 Hz): J10.1, R18.2, R19.2, R20.1, U13.11, Z9.2 (A)
D (4697 Hz): J12.1, R22.2, R23.2, R24.1, U13.9, Z11.2 (A)
D# (4976 Hz): J3.1, R26.2, R37.2, R43.1, U14.9, Z13.2 (A)
E (5274 Hz): J5.1, R28.2, R38.2, R44.1, U14.11, Z14.2 (A)
F (5590 Hz): J7.1, R30.2, R39.2, R45.1, U14.13, Z15.2 (A)
F# (5923 Hz): J13.1, R36.2, R42.2, R48.1, U14.1, Z18.2 (A)
G (6275 Hz): J9.1, R32.2, R40.2, R46.1, U14.3, Z16.2 (A)
G# (6642 Hz): J11.1, R34.2, R41.2, R47.1, U14.5, Z17.2 (A)
GND: J1.A2, J1.A4, J1.A6, J1.A8, J1.A10, J1.A12, J1.A14, J1.A16, J1.A18, J1.A20, J1.A32, J1.A34, J1.A36, J1.A38, J1.A40, J1.A42, J1.A44, J1.A46, J1.A48, J1.B2, J1.B4, J1.B6, J1.B8, J1.B10, J1.B12, J1.B14, J1.B16, J1.B18, J1.B20, J1.B32, J1.B34, J1.B36, J1.B38, J1.B40, J1.B42, J1.B44, J1.B46, J1.B48, U1.2 (-), U1.5 (+), U2.2 (-), U2.5 (+), U3.2 (-), U3.5 (+), U4.2 (-), U4.5 (+), U5.2 (-), U5.5 (+), U6.2 (-), U6.5 (+), U7.2 (-), U7.5 (+), U8.2 (-), U8.5 (+), U9.2 (-), U9.5 (+), U10.2 (-), U10.5 (+), U11.2 (-), U11.5 (+), U12.2 (-), U12.5 (+), U13.7 (VSS), U14.7 (VSS), Z2.2 (A), Z4.2 (A), Z6.2 (A), Z8.2 (A), Z10.2 (A), Z12.2 (A), Z19.2 (A), Z20.2 (A), Z21.2 (A), Z22.2 (A), Z23.2 (A), Z24.2 (A)
unnamed: C1.2, R1.1, U1.7
unnamed: C2.2, R5.1, U2.7
unnamed: C3.2, R9.1, U3.7
unnamed: C4.2, R13.1, U4.7
unnamed: C5.2, R17.1, U5.7
unnamed: C6.2, R21.1, U6.7
unnamed: C7.2, R25.1, U7.7
unnamed: C8.2, R27.1, U8.7
unnamed: C9.2, R29.1, U9.7
unnamed: C10.2, R31.1, U11.7
unnamed: C11.2, R33.1, U12.7
unnamed: C12.2, R35.1, U10.7
unnamed: R3.1, U1.1
unnamed: R7.1, U2.1
unnamed: R11.1, U3.1
unnamed: R15.1, U4.1
unnamed: R19.1, U5.1
unnamed: R23.1, U6.1
unnamed: R37.1, U7.1
unnamed: R38.1, U8.1
unnamed: R39.1, U9.1
unnamed: R40.1, U11.1
unnamed: R41.1, U12.1
unnamed: R42.1, U10.1
unnamed: R1.2, R2.1, U1.3 (+)
unnamed: C1.1, R4.2, U1.6 (-)
unnamed: R5.2, R6.1, U2.3 (+)
unnamed: C2.1, R8.2, U2.6 (-)
unnamed: R9.2, R10.1, U3.3 (+)
unnamed: C3.1, R12.2, U3.6 (-)
unnamed: R13.2, R14.1, U4.3 (+)
unnamed: C4.1, R16.2, U4.6 (-)
unnamed: R17.2, R18.1, U5.3 (+)
unnamed: C5.1, R20.2, U5.6 (-)
unnamed: R21.2, R22.1, U6.3 (+)
unnamed: C6.1, R24.2, U6.6 (-)
unnamed: R25.2, R26.1, U7.3 (+)
unnamed: C7.1, R43.2, U7.6 (-)
unnamed: R27.2, R28.1, U8.3 (+)
unnamed: C8.1, R44.2, U8.6 (-)
unnamed: R29.2, R30.1, U9.3 (+)
unnamed: C9.1, R45.2, U9.6 (-)
unnamed: R35.2, R36.1, U10.3 (+)
unnamed: C12.1, R48.2, U10.6 (-)
unnamed: R31.2, R32.1, U11.3 (+)
unnamed: C10.1, R46.2, U11.6 (-)
unnamed: R33.2, R34.1, U12.3 (+)
unnamed: C11.1, R47.2, U12.6 (-)
unnamed: Z1.1 (K), Z2.1 (K)
unnamed: Z3.1 (K), Z4.1 (K)
unnamed: Z5.1 (K), Z6.1 (K)
unnamed: Z7.1 (K), Z8.1 (K)
unnamed: Z9.1 (K), Z10.1 (K)
unnamed: Z11.1 (K), Z12.1 (K)
unnamed: Z13.1 (K), Z19.1 (K)
unnamed: Z14.1 (K), Z20.1 (K)
unnamed: Z15.1 (K), Z21.1 (K)
unnamed: Z16.1 (K), Z22.1 (K)
unnamed: Z17.1 (K), Z23.1 (K)
unnamed: Z18.1 (K), Z24.1 (K)
TONE 1: J1.A21, U13.6
TONE 2: J1.A23, U13.4
TONE 3: J1.A25, U13.2
TONE 4: J1.A27, U13.12
TONE 5: J1.A29, U13.10
TONE 6: J1.A31, U13.8
TONE 7: J1.B21, U14.8
TONE 8: J1.B23, U14.10
TONE 9: J1.B25, U14.12
TONE 10: J1.B27, U14.2
TONE 11: J1.B29, U14.4
TONE 12: J1.B31, U14.6

Notes on the sheet:
C Note Oscillator
F# Note Oscillator
B Note Oscillator
A# Note Oscillator
C# Note Oscillator
A Note Oscillator
E Note Oscillator
Edge Connector
D Note Oscillator
G Note Oscillator
F Note Oscillator
D# Note Oscillator
G# Note Oscillator
