Celcius1/Old-Projects-become-New/Lyrebird Keyboard/Lyrebird Keyboard Tone Generator/Lyrebird Keyboard Tone Generator.kicad_pcb

## KiCad design Lyrebird Keyboard/Lyrebird Keyboard Tone Generator/Lyrebird Keyboard Tone Generator.kicad_pcb (continued)

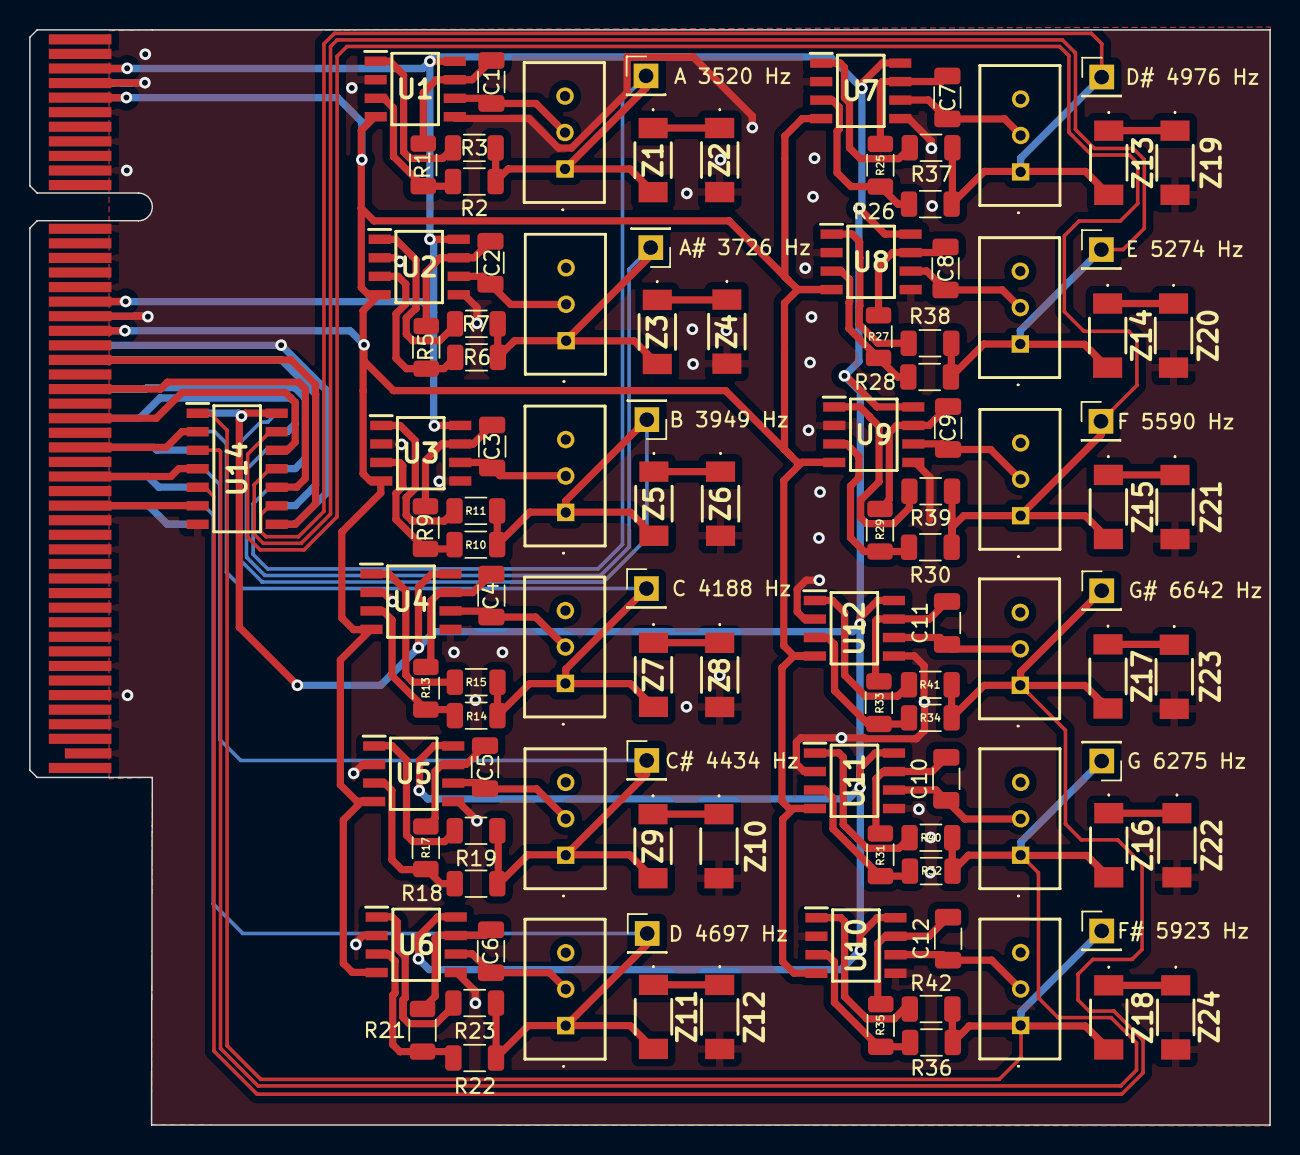
[picture p9: board Lyrebird Keyboard Tone Generator.kicad_pcb from above]

Board: 2 copper layers, 85.1 x 75.2 mm, 111 parts (1 on the bottom side), 87 nets.
