Celcius1/Old-Projects-become-New/(commit log)

2023-10-03 First Upload
    [Audio Spectrum Analyser.kicad_pcb, Audio Spectrum Analyser.kicad_sch]
2023-10-07 Design of PSU so far
    [New PSU for Projects.kicad_pcb, New PSU for Projects.kicad_sch, PSUOutput.kicad_sch]
2023-10-07 Swapped out Op-Amp for a Comparator
    [New PSU for Projects.kicad_sch, PSUOutput.kicad_sch]
2023-10-07 Minor Change to feedback circuit
    [New PSU for Projects.kicad_sch, PSUOutput.kicad_sch]
2023-10-08 A few minor changes
    [New PSU for Projects.kicad_sch, PSUOutput.kicad_sch]
2023-12-06 Lyrebird Initial Upload
    [Lyrebird Keyboard.kicad_pcb, Lyrebird Keyboard.kicad_sch, New PSU for Projects.kicad_sch]
2023-12-07 additional tracks laid
    [Lyrebird Keyboard.kicad_pcb, Lyrebird Keyboard.kicad_sch]
2023-12-08 Added schematic definitions
    [Lyrebird Keyboard.kicad_sch]
2023-12-09 Tracks almost finished
    [Lyrebird Keyboard.kicad_pcb, Lyrebird Keyboard.kicad_sch]
2023-12-10 Mainboard Complete
    [Lyrebird Keyboard.kicad_pcb, Lyrebird Keyboard.kicad_sch]
2023-12-10 Working on Tone Generator
    [Lyrebird Keyboard Tone Generator.kicad_pcb, Lyrebird Keyboard Tone Generator.kicad_sch, Lyrebird Keyboard.kicad_sch, Notes 2.kicad_sch, Notes.kicad_sch]
2023-12-11 Further Tone Generator Work, Diode mixers placed
    [Lyrebird Keyboard Tone Generator.kicad_pcb, Notes 2.kicad_sch, Notes.kicad_sch]
2023-12-12 Major Design Changes
    Completed Tone Generator Board, board now only provides base notes, individual notes will be generated on the wave shaping boards.
    Made major changes to pci slot config, and have increased grounding of the slots.
    May need decoupling capacitors on tone generator board, but tight for room
    [Lyrebird Keyboard Tone Generator.kicad_pcb, Lyrebird Keyboard Tone Generator.kicad_sch, Lyrebird Keyboard.kicad_pcb, Notes 2.kicad_sch, Notes.kicad_sch]
2023-12-12 Mainboard Changes
    Adjusted mainboard, the longer PCI slots are now instrument slots not wave shaper slots, and slot 4 in the longer is also able to support midi implementation
    [Lyrebird Keyboard.kicad_pcb, Lyrebird Keyboard.kicad_sch]
2023-12-13 Piano Board Layout
    Started doing circuit that creates the piano sound.
    [ENV 1-16.kicad_sch, ENV 17-34.kicad_sch, ENV 35-52.kicad_sch, Lyrebird Keyboard Piano Card.kicad_pcb, Lyrebird Keyboard Piano Card.kicad_sch, Lyrebird Keyboard.kicad_pcb, Lyrebird Keyboard.kicad_sch, Notes 2.kicad_sch]
2023-12-15 Design Changes
    Fix a number of symbol issues, and connection faults
    [ENV 1-16.kicad_sch, ENV 17-34.kicad_sch, ENV 35-52.kicad_sch, ENV 53-70.kicad_sch, ENV 71-73.kicad_sch, Lyrebird Keyboard Piano Card.kicad_sch, Lyrebird Keyboard.kicad_pcb, Lyrebird Keyboard.kicad_sch]
2023-12-16 Schematic Updates
    Made updates to schematics, to use correct symbols, and minor PCB updates, further work on the piano card design
    [EFFECTS.kicad_sch, ENV 1-16.kicad_sch, ENV 17-34.kicad_sch, ENV 35-52.kicad_sch, ENV 53-70.kicad_sch, ENV 71-73.kicad_sch, Lyrebird Keyboard Piano Card.kicad_sch, Lyrebird Keyboard Tone Generator.kicad_sch]
2023-12-18 Move PSU and Amp off of mainboard
    Moved Power Supply to its own board, single layer. Moved Class D amp onto a daughter board, modifiying to also have a 1/4" balanced output as well as amplified output
    [Lyrebird Keyboard Class D Amp Card.kicad_pcb, Lyrebird Keyboard Class D Amp Card.kicad_sch, Lyrebird Keyboard Interconnect Mainboard.kicad_pcb, Lyrebird Keyboard Interconnect Mainboard.kicad_sch, Lyrebird Keyboard Power Supply.kicad_pcb, Lyrebird Keyboard Power Supply.kicad_sch, Lyrebird Keyboard Tone Generator.kicad_pcb, Lyrebird Keyboard Tone Generator.kicad_sch]
2023-12-20 Added KiCAD library
    Uploaded current ECAD library, to facilitate editing away from main work computer
    [Lyrebird Keyboard Class D Amp Card.kicad_pcb, Lyrebird Keyboard Class D Amp Card.kicad_sch, Lyrebird Keyboard Power Supply.kicad_pcb, Lyrebird Keyboard Power Supply.kicad_sch]
